jonathanw82/Fan_speed_control/Fan_speed_controllerV1.25/encoderButton.ino

//~~~~~~~~~~~~~~~~~~~~~~~~~~~~~~~~~~~~~~~~ Enter Pressed ~~~~~~~~~~~~~~~~~~~~~~~~~~~~~~~~~~~~~~~~~
void buttonPressed() {

  if (middle) //Middle Button is Pressed
  {
    middle = false;

    if (page == 1 && menuitem == 1)
    {
      middle = false;
      menuitem ++;
      menuEnter ++;
      lcd.clear();
      value = 0;
    }
    
    if (page == 1 && menuitem == 3 && menuEnter == 1)
    {
      middle = false;
      page = 2;
      enter = 1;
    }
    else if (page == 2 && menuitem == 3 && enter == 1 && menuEnter == 1)
    {
      middle = false;
      page = 1;
      enter = 0;
    }
    
    if (page == 1 && menuitem == 4 && menuEnter == 1)
    {
      middle = false;
      page = 2;
      enter = 1;
    }
    else if (page == 2 && menuitem == 4 && enter == 1 && menuEnter == 1)
    {
      middle = false;
      page = 1;
      enter = 0;
    }
    
    if (page == 1 && menuitem == 5 && menuEnter == 1)
    {
      middle = false;
      page = 2;
      enter = 1;
    }
    else if (page == 2 && menuitem == 5 && enter == 1 && menuEnter == 1)
    {
      middle = false;
      page = 1;
      enter = 0;
    }
    
    if (page == 1 && menuitem == 6 && menuEnter == 1)
    {
      middle = false;
      page = 2;
      enter = 1;
    }
    else if (page == 2 && menuitem == 6 && enter == 1 && menuEnter == 1)
    {
      middle = false;
      page = 1;
      enter = 0;
    }
    
    if (page == 1 && menuitem == 7 && menuEnter == 1)
    {
      middle = false;
      page = 2;
      enter = 1;
    }
    else if (page == 2 && menuitem == 7 && enter == 1 && menuEnter == 1)
    {
      middle = false;
      page = 1;
      enter = 0;
    }
    
    if (page == 1 && menuitem == 8 && menuEnter == 1)
    {
      middle = false;
      page = 2;
      enter = 1;
    }
    else if (page == 2 && menuitem == 8 && enter == 1 && menuEnter == 1)
    {
      middle = false;
      page = 1;
      enter = 0;
    }

    if (page == 1 && menuitem == 9 && menuEnter == 1)
    {
      middle = false;
      page = 2;
      enter = 1;
    }
    else if (page == 2 && menuitem == 9 && enter == 1 && menuEnter == 1)
    {
      middle = false;
      page = 1;
      enter = 0;
    }
    
    if (page == 1 && menuitem == 10 && menuEnter == 1)
    {
      middle = false;
      page = 2;
      enter = 1;
    }
    else if (page == 2 && menuitem == 10 && enter == 1 && menuEnter == 1)
    {
      middle = false;
      page = 1;
      enter = 0;
    }

    if (page == 1 && menuitem == 11 && menuEnter == 1)
    {
      middle = false;
      page = 1;
      enter = 0;
      menuEnter = 0;
      menuitem = 1;
      lcd.clear();
      value = 0;
    }
  }
}
