jonathanw82/Fan_speed_control/Fan_speed_controllerV1.25/wifi.ino

bool wifi() {
  // check for the WiFi module:
  if (WiFi.status() == WL_NO_MODULE) {
    Serial.println(F("Communication with WiFi module failed!"));
    // don't continue
    while (true);
  }

  while (status != WL_CONNECTED) {                                // attempt to connect to WiFi network:
    Serial.println(F("Attempting to connect to wifi network"));
    Serial.print(F("WiFi name: "));
    Serial.println(WIFI_NAME);
    Serial.print(F("WiFi password: "));
    Serial.println(WIFI_PASSWORD);
    lcd.setCursor(0, 0);
    lcd.print(F("Connecting WiFi "));
    lcd.setCursor(0, 1);
    lcd.print(F("Please Wait!    "));
    // Connect to WPA/WPA2 network:
    status = WiFi.begin(WIFI_NAME, WIFI_PASSWORD);
    // wait 5 seconds for connection:
    delay(5000);
    // you're connected now, so print out the data:
    if (status != WL_CONNECTED) {
      isWifiConnectedCounter++;
      Serial.println(F("Wifi Not connected"));
      if (isWifiConnectedCounter == 2) {
        Serial.println(F("Wifi Not connected check connection"));
        Serial.println(F("Booting standard controller"));
        return false;
      }
    } else {
      Serial.println(F("connection successfull!"));
      setUpMqtt();                              // Setup The MQTT protacol
      return true;
    }
  }
}
