jonathanw82/Fan_speed_control/Fan_speed_controllerV1.25/debug.ino

//~~~~~~~~~~~~~~~~~~~~~~~~~~~~~~~~~~~~~~~~~~~~~~ DeBug ~~~~~~~~~~~~~~~~~~~~~~~~~~~~~~~~~~~~~~~
void deBug() {

//  Serial.print(fanInVolts);
//  Serial.println(" volts");
//  Serial.print(fanPercentage);
//  Serial.println(F( " %"));
//  Serial.print(" Encoder Value =");
//  Serial.println(value);
//  Serial.print(" Menu Item =");
//  Serial.println(menuitem);
//  Serial.print(" page =");
//  Serial.println(page);
//  Serial.print(" menuEnter =");
//  Serial.println(menuEnter);
//  Serial.print(" currentMode =");
//  Serial.println(currentMode);
//  Serial.println(manualFanSpeed);
//  Serial.print("Speed = ");
//  Serial.println(fanSpeed);
//  Serial.print("tempMax = ");
//  Serial.println(tempMax);
//  Serial.print("Chip serial number");
//  Serial.println(sht3x.readSerialNumber());
//  Serial.print("Current Hum = ");
//  Serial.println(hum);
//  Serial.print("Current Temp = ");
//  Serial.println(temp);
//  int sb = digitalRead(standBySwitch);
//  Serial.print("SBSWITCH = ");
//  Serial.println(sb);
//  Serial.println(target);
//  Serial.println(fanMax);
//  Serial.print("shutDown = ");
//  Serial.println(shutDown);
}
