jonathanw82/Fan_speed_control/(commit log)

2021-05-25 added more librarys, menu's and fan controll
2021-05-28 bebugging logic on fan speed
2021-05-28 adding status leds and standby power off feature
2021-06-03 adding standby wakeup after ac failure
    [Fan_speed_controller.ino, encoder.ino]
2021-06-03 sorted login on shoutdown with ac failure
    [Fan_speed_controller.ino]
2021-06-04 sorted running bug and added debounce for a manual stand by button
    [Fan_speed_controller.ino, debug.ino, encoder.ino, encoderButton.ino]
2021-06-04 sorted a bug in standby
    [Fan_speed_controller.ino]
2021-06-09 Tridy up the menu system and sorted display bug in PWM Value display
    [Fan_speed_controller.ino, debug.ino, encoder.ino, encoderButton.ino, startscreen.ino]
2021-06-09 added flow chart to repo
2021-06-09 added more info to readme also added temp and humid to diagnostics and added flow chart to repo
2021-06-09 wireing schymatic
2021-06-11 reversed the logic for rotary encoder turn direction clcokwise up anti clockwise down
    [encoder.ino]
2021-06-11 updated the flow chart for setup
2021-06-11 Added power consumption to reame
2021-06-11 edited power consumption
2021-06-17 chanded the temperature sensor check this works before merging to master
2021-06-17 added F macro to some Serial.prints
2021-06-18 removed redundant led
2021-07-04 created a new version with a new timer lib to work with uno wifi rev2
2021-07-04 added working bitbang code to get i2c in pins 12 and 13 for temp hum sensor
2021-07-04 addeed new files toi media
    [Fanspeed control.kicad_pcb, Fanspeed control.sch]
2021-07-16 added a new version 1.25 with failsafe
    [Fan_speed_controllerV1.25.ino, MQTT.ino, commands.ino, debug.ino, display.ino, encoder.ino, encoderButton.ino, startscreen.ino]
2021-07-16 Added fail safes for no wifi or no Mqtt connection to allow system to run independantly
    [Fan_speed_controllerV1.25.ino, MQTT.ino, commands.ino, wifi.ino]
2021-07-21 constrained the fan percatege to max 100
2021-07-23 Sorted logic on rotery encoder
2021-07-28 added another schematic
2021-07-28 added a new kiCad image to repo
    [Fanspeed control.kicad_pcb, Fanspeed control.sch, powerControlFanSpeed.kicad_pcb, powerControlFanSpeed.sch]
2021-08-09 added new parts to schymeatic+
    [Fanspeed control.sch]
2021-08-23 added to the readme about pwm and rc filter
    [Fanspeed control.sch]
